zzatuchni/smart_watch/hw/screenshots/mc power supply.png

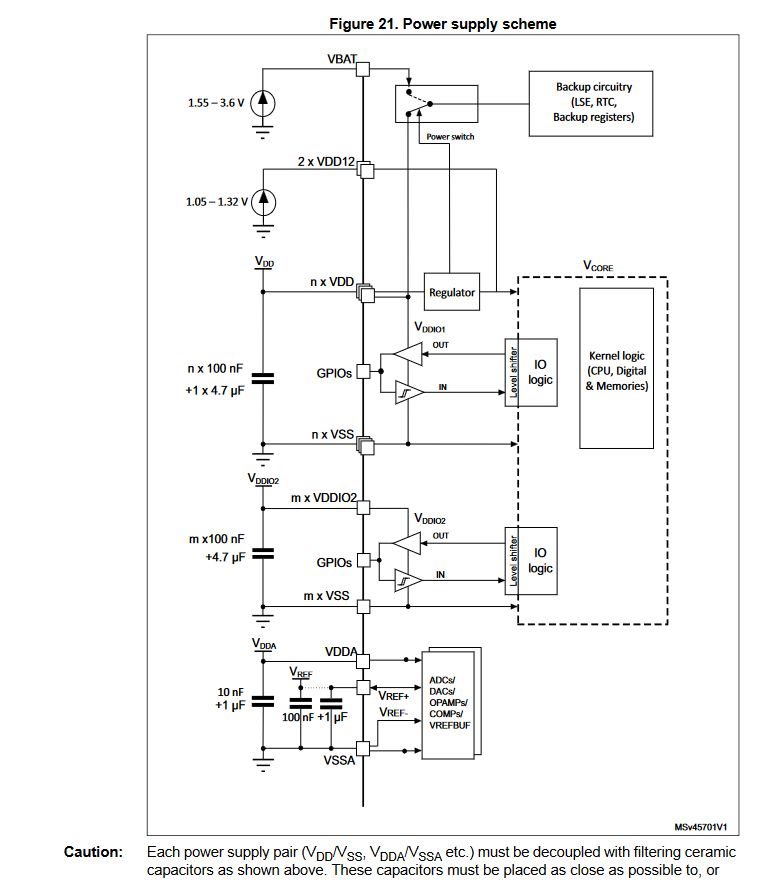
hw/screenshots/mc power supply.png
