zzatuchni/smart_watch/hw/kicad/smart_watch/smart_watch.kicad_pcb

## KiCad design hw/kicad/smart_watch/smart_watch.kicad_pcb (2025-05-13)

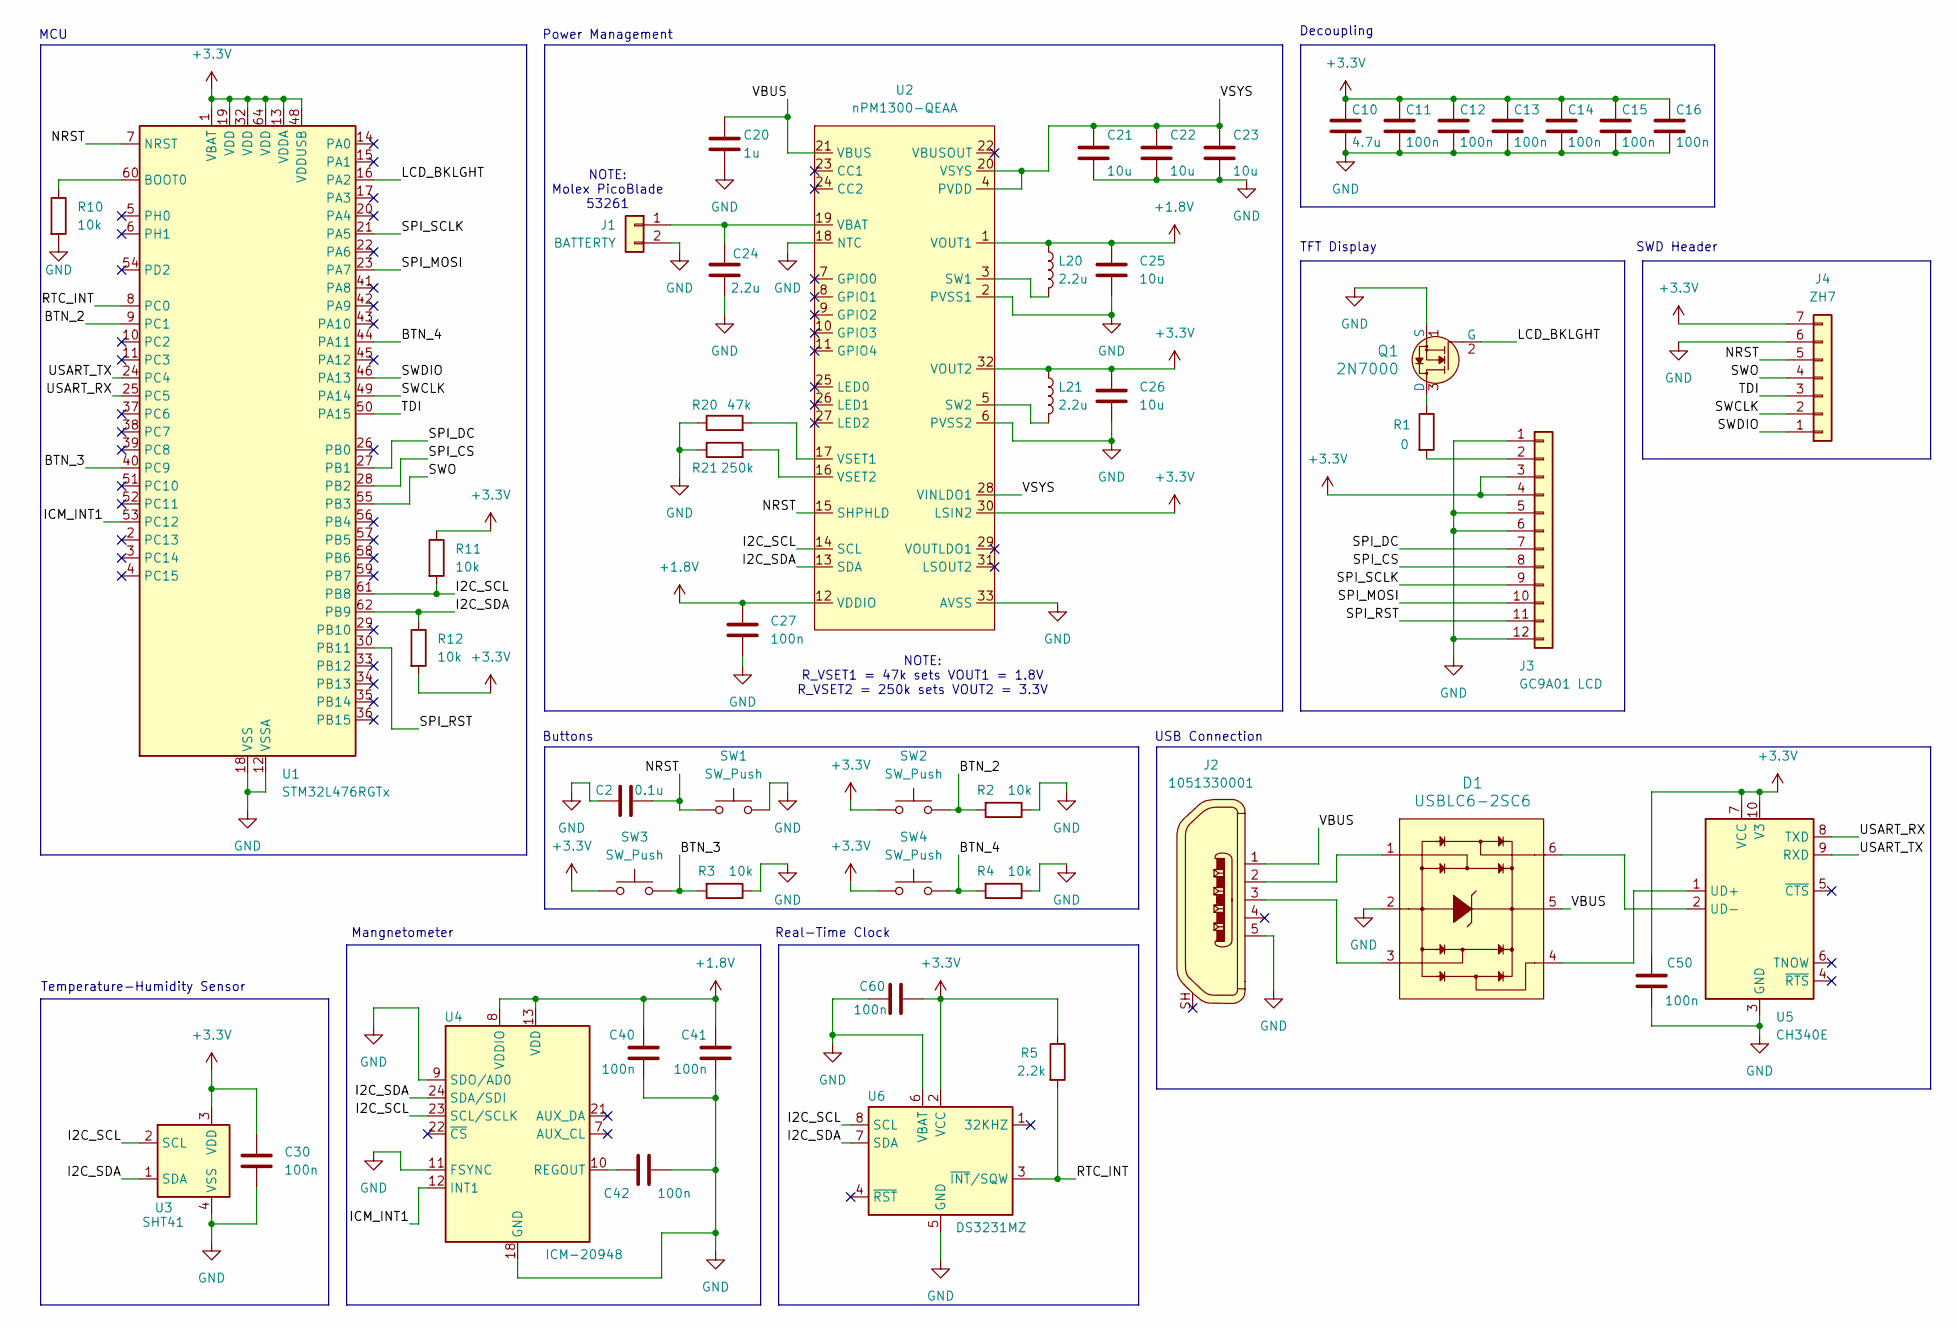
[picture p2: schematic smart_watch.kicad_sch, Smart Watch]

Parts:
C2: 0.1u; C_0603_1608Metric
C10: 4.7u; C_0603_1608Metric
C11, C12, C13, C14, C15, C16, C27, C30, C40, C41, C42, C50, C60: 100n; C_0603_1608Metric
C20: 1u; C_0603_1608Metric
C21, C22, C23, C25, C26: 10u; C_0603_1608Metric
C24: 2.2u; C_0603_1608Metric
D1: USBLC6-2SC6; SOT23-6L; MPN USBLC6-2SC6; Digi-Key_PN 497-5235-1-ND
J1: BATTERTY; Molex_PicoBlade_53261-0271_1x02-1MP_P1.25mm_Horizontal
J2: 1051330001; USB_Micro_B_Female_Vert_1051330001; MPN 1051330001; Digi-Key_PN WM9734CT-ND
J3: GC9A01 LCD; GC9A01_FPC_pads_P0.7mm
J4: ZH7; JST_ZH_S7B-ZR-SM4A-TF_1x07-1MP_P1.50mm_Horizontal
L20, L21: 2.2u; L_0603_1608Metric
Q1: 2N7000; SOT-23; MPN 2N7000; Digi-Key_PN 2N7000FS-ND
R1: 0; R_0603_1608Metric
R2, R3, R4, R10, R11, R12: 10k; R_0603_1608Metric
R5: 2.2k; R_0603_1608Metric
R20: 47k; R_0603_1608Metric
R21: 250k; R_0603_1608Metric
SW1, SW2, SW3, SW4: SW_Push; TL6340
U1: STM32L476RGTx; LQFP-64_10x10mm_P0.5mm
U2: nPM1300-QEAA; nPM1300
U3: SHT41; Sensirion_DFN-4_1.5x1.5mm_P0.8mm_SHT4x_NoCentralPad
U4: ICM-20948; InvenSense_QFN-24_3x3mm_P0.4mm
U5: CH340E; MSOP-10_3x3mm_P0.5mm
U6: DS3231MZ; SOIC-8_3.9x4.9mm_P1.27mm

Connections:
+1.8V: C25.1, C27.1, C40.2, C41.2, L20.1, U2.1 (VOUT1), U2.12 (VDDIO), U4.8 (VDDIO), U4.13 (VDD)
/BTN_2: R2.2, SW2.2, U1.9 (PC1)
/BTN_3: R3.2, SW3.2, U1.40 (PC9)
/BTN_4: R4.2, SW4.2, U1.44 (PA11)
/I2C_SCL: R11.2, U1.61 (PB8), U2.14 (SCL), U3.2 (SCL), U4.23 (SCL/SCLK), U6.8 (SCL)
/I2C_SDA: R12.1, U1.62 (PB9), U2.13 (SDA), U3.1 (SDA), U4.24 (SDA/SDI), U6.7 (SDA)
/ICM_INT1: U1.53 (PC12), U4.12 (INT1)
/LCD_BKLGHT: Q1.2 (G), U1.16 (PA2)
/NRST: C2.2, J4.5, SW1.1, U1.7 (NRST), U2.15 (SHPHLD)
/RTC_INT: R5.2, U1.8 (PC0), U6.3 (~INT/SQW)
/SPI_CS: J3.8, U1.28 (PB2)
/SPI_DC: J3.7, U1.27 (PB1)
/SPI_MOSI: J3.10, U1.23 (PA7)
/SPI_RST: J3.11, U1.30 (PB11)
/SPI_SCLK: J3.9, U1.21 (PA5)
/SWCLK: J4.2, U1.49 (PA14)
/SWDIO: J4.1, U1.46 (PA13)
/SWO: J4.4, U1.55 (PB3)
/TDI: J4.3, U1.50 (PA15)
/USART_RX: U1.25 (PC5), U5.8 (TXD)
/USART_TX: U1.24 (PC4), U5.9 (RXD)
/VBUS: C20.1, D1.5, J2.1, U2.21 (VBUS)
/VSYS: C21.2, C22.2, C23.2, U2.4 (PVDD), U2.20 (VSYS), U2.28 (VINLDO1)
unnamed: D1.1, J2.2
unnamed: D1.3, J2.3
unnamed: C24.1, J1.1, U2.19 (VBAT)
unnamed: J3.2, R1.2
unnamed: Q1.3 (D), R1.1
unnamed: R10.1, U1.60 (BOOT0)
unnamed: L20.2, U2.3 (SW1)
unnamed: L21.2, U2.5 (SW2)
unnamed: R20.2, U2.17 (VSET1)
unnamed: R21.2, U2.16 (VSET2)
unnamed: C42.2, U4.10 (REGOUT)
unnamed: D1.4, U5.1 (UD+)
unnamed: D1.6, U5.2 (UD-)

Notes on the sheet:
Mangnetometer
SWD Header
NOTE: Molex PicoBlade 53261
Temperature-Humidity Sensor
USB Connection
TFT Display
Power Management
Real-Time Clock
Buttons
NOTE: R_VSET1 = 47k sets VOUT1 = 1.8V R_VSET2 = 250k sets VOUT2 = 3.3V
MCU
Decoupling

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
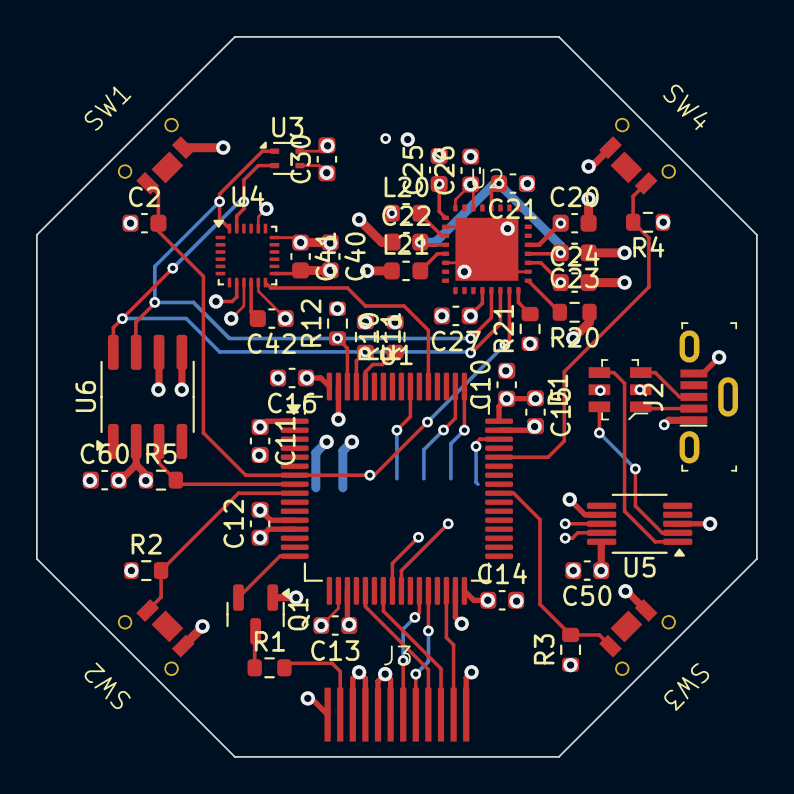
[picture p3: board smart_watch.kicad_pcb from above]

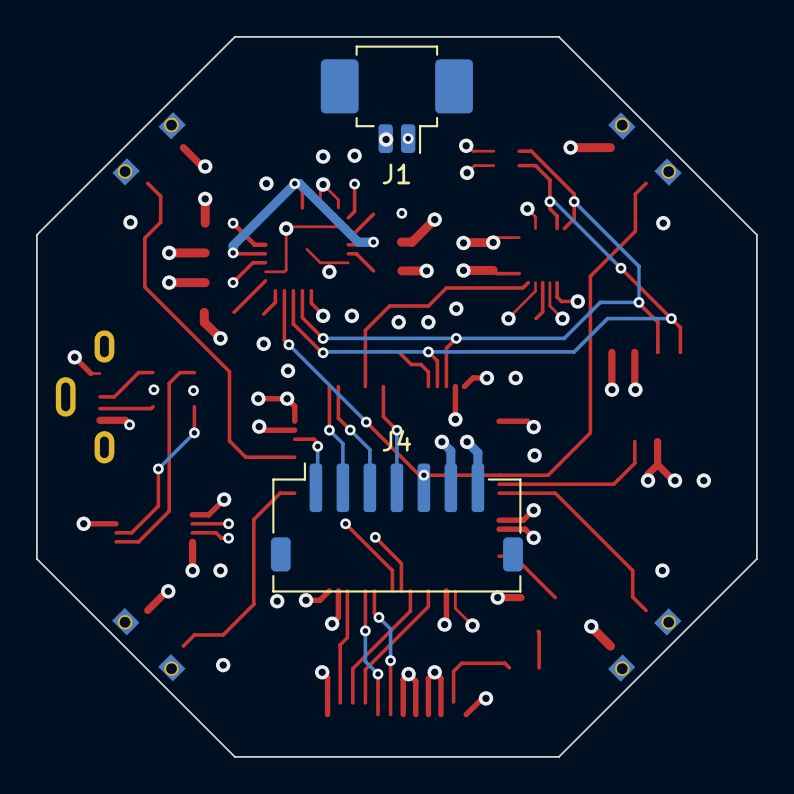
[picture p4: board smart_watch.kicad_pcb from below]

Board: 4 copper layers, 40.0 x 40.0 mm, 50 parts (2 on the bottom side), 38 nets.
