zzatuchni/smart_watch/sw/src/main.c

#include "devices/stm32l47x/basic.h"
#include "devices/stm32l47x/gpio.h"
#include "devices/stm32l47x/uart.h"
#include "devices/stm32l47x/rtc.h"

#include "devices/gc9a01/gc9a01.h"

#include "devices/sht41/sht41.h"

#include "devices/icm20948/icm20948.h"

#include "devices/lis2mdl/lis2mdl.h"

#include "devices/misc/misc.h"

#include "images/test_font.h"

#include "interrupts.h"
#include "debug.h"

////////////////////////////////////////////////////////////
//  Startup code 
////////////////////////////////////////////////////////////

char date_buf[12] = { '0' };
char date_buf_prev[12] = { '0' };

char temp_buf[2] = { '0' };
char temp_buf_prev[2] = { '0' };

const RTC_Time test_time = {
    2024,
    5,
    5,
    5,
    30,
    30,
    30
};

void dbg_print_date(RTC_Time *time) {
    DPRINT("WD ");
    DPRINTN(time->weekday);

    DPRINT(" Y ");
    DPRINTN(time->year);

    DPRINT(" M ");
    DPRINTN(time->month);

    DPRINT(" D ");
    DPRINTN(time->day);

    DPRINT(" h ");
    DPRINTN(time->hour);

    DPRINT(" m ");
    DPRINTN(time->minute);

    DPRINT(" s ");
    DPRINTN(time->second);

    DPRINT(" ss ");
    DPRINTN(time->subsecond);

    DPRINTNL();
}

int main(void) {
    ENABLE_DBG_TRACES();

    systick_init(DEFAULT_SYSCLK_FREQ / 1000);

    button_init(BUTTON1_PIN);

    Result res = gc9a01_init();
    if (res) { DPRINT("LCD INIT ERR "); DPRINTN(res); for (;;) {} };
    
    res = rtc_init();
    if (res) { DPRINT("RTC INIT ERR "); DPRINTN(res); for (;;) {} };

    res = i2c_init(&common_i2c_config);
    if (res) { DPRINT("I2C INIT ERR "); DPRINTN(res); for (;;) {} };

    //res = lis2mdl_init(&common_i2c_config);
    //if (res) { DPRINT("LIS2 INIT ERR "); DPRINTN(res); for (;;) {} };

    RTC_Time time;
    Temp_Humidity_Data th_data;
    //Magnetometer_Raw_Data mgmtr_data;

    // draw the backround
    const GC9A01_Frame bg_frame = {0, 0, GC9A01A_TFTWIDTH, GC9A01A_TFTHEIGHT};
    res = gc9a01_draw_colors_from_bitmask(checkerboard, 29, GC9A01A_BLUE2, GC9A01A_BLUE3, &bg_frame, 16);

    const int sx_scale2 = 16;
    const int sy_scale2 = 32;

    const int sx_scale3 = 24;
    const int sy_scale3 = 48;

    const int sx_scale5 = 40;
    const int sy_scale5 = 80;

    for (;;) {
        
        // gather data
        res = rtc_get_time(&time);
        if (res) { DPRINT("RTC GET TIME ERR "); DPRINTN(res); for (;;) {} };
        dbg_print_date(&time);

        int_to_str(time.hour, date_buf, 2, 10);
        int_to_str(time.minute, date_buf + 2, 2, 10);
        int_to_str(time.second, date_buf + 4, 2, 10);

        res = sht41_get_temp_hum_data(&th_data, SHT41_HI_PREC);
        if (res) { DPRINT("GET TEMP ERR "); DPRINTN(res); for (;;) {} };
        int_to_str(th_data.t_degC, temp_buf, 2, 10);

        DPRINT("TEMP ");
        DPRINTN(th_data.t_degC);
        DPRINT("\r\n");

        // start drawing
        GC9A01_Color col = GC9A01A_WHITE;

        int sx = sx_scale2;
        int sy = sy_scale2;
        GC9A01_Frame frame = { 182, 32, sx, sy };

        // write temp
        if (!str_cmp(temp_buf, temp_buf_prev, 2)) {
            gc9a01_draw_colors_from_bitmask(test_font_char_bitmap_bufs[temp_buf[0]-48], 16, col, GC9A01A_BLACK, &frame, 2);
            frame.x -= (sx + 2);
            gc9a01_draw_colors_from_bitmask(test_font_char_bitmap_bufs[temp_buf[1]-48], 16, col, GC9A01A_BLACK, &frame, 2);
            frame.x -= (sx + 2);
            gc9a01_draw_colors_from_bitmask(test_font_char_bitmap_bufs[15], 16, col, GC9A01A_BLACK, &frame, 2);
        }

        // write heading
        frame.x = 42;
        gc9a01_draw_colors_from_bitmask(test_font_char_bitmap_bufs[11], 16, col, GC9A01A_BLACK, &frame, 2);
        frame.x += (sx + 2);
        gc9a01_draw_colors_from_bitmask(test_font_char_bitmap_bufs[0], 16, col, GC9A01A_BLACK, &frame, 2);
        frame.x += (sx + 2);
        gc9a01_draw_colors_from_bitmask(test_font_char_bitmap_bufs[0], 16, col, GC9A01A_BLACK, &frame, 2);
        frame.x += (sx + 2);
        gc9a01_draw_colors_from_bitmask(test_font_char_bitmap_bufs[0], 16, col, GC9A01A_BLACK, &frame, 2);

        // write time
        sx = sx_scale5;
        sy = sy_scale5;
        GC9A01_Frame frame2 = { 10, 80, sx, sy };

        if (!str_cmp(date_buf+2, date_buf_prev+2, 2)) {
            gc9a01_draw_colors_from_bitmask(test_font_char_bitmap_bufs[date_buf[3]-48], 16, col, GC9A01A_BLACK, &frame2, 5);
            frame2.x += (sx + 5);
            gc9a01_draw_colors_from_bitmask(test_font_char_bitmap_bufs[date_buf[2]-48], 16, col, GC9A01A_BLACK, &frame2, 5);
        }
        
        frame2.x = 100;
        gc9a01_draw_colors_from_bitmask(test_font_char_bitmap_bufs[14], 16, col, GC9A01A_BLACK, &frame2, 5);
        frame2.x += (sx + 5);

        if (!str_cmp(date_buf, date_buf_prev, 2)) {
            gc9a01_draw_colors_from_bitmask(test_font_char_bitmap_bufs[date_buf[1]-48], 16, col, GC9A01A_BLACK, &frame2, 5);
            frame2.x += (sx + 5);
            gc9a01_draw_colors_from_bitmask(test_font_char_bitmap_bufs[date_buf[0]-48], 16, col, GC9A01A_BLACK, &frame2, 5);
        }
        


        // write date

        sx = sx_scale2;
        sy = sy_scale2;
        GC9A01_Frame frame3 = { 48, 180, sx, sy };
        gc9a01_draw_colors_from_bitmask(test_font_char_bitmap_bufs[0], 16, col, GC9A01A_BLACK, &frame3, 2);
        frame3.x += (sx + 2);
        gc9a01_draw_colors_from_bitmask(test_font_char_bitmap_bufs[0], 16, col, GC9A01A_BLACK, &frame3, 2);
        frame3.x += (sx + 2);
        gc9a01_draw_colors_from_bitmask(test_font_char_bitmap_bufs[16], 16, col, GC9A01A_BLACK, &frame3, 2);
        frame3.x += (sx + 2);
        gc9a01_draw_colors_from_bitmask(test_font_char_bitmap_bufs[0], 16, col, GC9A01A_BLACK, &frame3, 2);
        frame3.x += (sx + 2);
        gc9a01_draw_colors_from_bitmask(test_font_char_bitmap_bufs[0], 16, col, GC9A01A_BLACK, &frame3, 2);
        frame3.x += (sx + 2);
        gc9a01_draw_colors_from_bitmask(test_font_char_bitmap_bufs[16], 16, col, GC9A01A_BLACK, &frame3, 2);
        frame3.x += (sx + 2);
        gc9a01_draw_colors_from_bitmask(test_font_char_bitmap_bufs[0], 16, col, GC9A01A_BLACK, &frame3, 2);
        frame3.x += (sx + 2);
        gc9a01_draw_colors_from_bitmask(test_font_char_bitmap_bufs[0], 16, col, GC9A01A_BLACK, &frame3, 2);

        str_copy(date_buf, date_buf_prev, 6);
        str_copy(temp_buf, temp_buf_prev, 2);

        if (button1_pressed) {
            button1_pressed = false;
            DPRINT("Button pressed ");
            res = rtc_set_time(&test_time);
            if (res) { DPRINT("RTC SET TIME ERR "); DPRINTN(res); for (;;) {} };
        }

        spin(5000);
    }

    /*    
    for (;;) {
        res = rtc_get_time(&time);
        if (res) { DPRINT("RTC GET TIME ERR "); DPRINTN(res); for (;;) {} };

        int_to_str(time.hour, date_buf, 2, 10);
        int_to_str(time.minute, date_buf + 2, 2, 10);
        int_to_str(time.second, date_buf + 4, 2, 10);

        if (!str_cmp(date_buf, date_buf_prev, 2)) {
            gc9a01_draw_colors_from_bitmask(test_font_char_bitmap_bufs[date_buf[0]-48], 16, GC9A01A_WHITE, GC9A01A_BLACK, &ht_frame, 6);
            gc9a01_draw_colors_from_bitmask(test_font_char_bitmap_bufs[date_buf[1]-48], 16, GC9A01A_RED, GC9A01A_BLACK, &hu_frame, 6);
        }

        if (!str_cmp(date_buf+2, date_buf_prev+2, 2)) {
            gc9a01_draw_colors_from_bitmask(test_font_char_bitmap_bufs[date_buf[2]-48], 16, GC9A01A_WHITE, GC9A01A_BLACK, &mt_frame, 6);
            gc9a01_draw_colors_from_bitmask(test_font_char_bitmap_bufs[date_buf[3]-48], 16, GC9A01A_RED, GC9A01A_BLACK, &mu_frame, 6);
        }

        if (!str_cmp(date_buf+4, date_buf_prev+4, 2)) {
            gc9a01_draw_colors_from_bitmask(test_font_char_bitmap_bufs[date_buf[4]-48], 16, GC9A01A_WHITE, GC9A01A_BLACK, &st_frame, 4);
            gc9a01_draw_colors_from_bitmask(test_font_char_bitmap_bufs[date_buf[5]-48], 16, GC9A01A_RED, GC9A01A_BLACK, &su_frame, 4);   
        }

        str_copy(date_buf, date_buf_prev, 6);

        if (button1_pressed) {
            button1_pressed = false;
            DPRINT("Button pressed ");
            res = rtc_set_time(&test_time);
            if (res) { DPRINT("RTC SET TIME ERR "); DPRINTN(res); for (;;) {} };
        }

        res = sht41_get_temp_hum_data(&th_data, SHT41_HI_PREC);
        if (res) { DPRINT("GET TEMP ERR "); DPRINTN(res); for (;;) {} };

        //res = lis2mdl_get_raw_data(&mgmtr_data);
        //if (res) { DPRINT("GET MGMT ERR "); DPRINTN(res); for (;;) {} };

        DPRINT("TEMP ");
        DPRINTN(th_data.t_degC);
        DPRINT("\r\n");
        DPRINT("HUM ");
        DPRINTN(th_data.rh_pRH);
        DPRINT("\r\n");
        //DPRINT("X ");
        //DPRINTNS((int32_t)mgmtr_data.x);
        //DPRINT("\r\n");
        //DPRINT("Y ");
        //DPRINTNS((int32_t)mgmtr_data.y);
        //DPRINT("\r\n");
        //DPRINT("Z ");
        //DPRINTNS((int32_t)mgmtr_data.z);
        //DPRINT("\r\n");

        //int16_t deg = lis2mdl_get_heading_degrees(mgmtr_data.y, mgmtr_data.x);
        //DPRINT("DEG ");
        //DPRINTNS((int32_t)mgmtr_data.z);
        //DPRINT("\r\n");

        spin(500000);
    }
    */

    return 0;
}

__attribute__((naked, noreturn)) void _reset(void) {
  // memset .bss to zero, and copy .data section to RAM region
  extern long _sbss, _ebss, _sdata, _edata, _sidata;
  for (long *dst = &_sbss; dst < &_ebss; dst++) *dst = 0;
  for (long *dst = &_sdata, *src = &_sidata; dst < &_edata;) *dst++ = *src++;

  main();             // Call main()
  for (;;) (void) 0;  // Infinite loop in the case if main() returns
}

extern void _estack(void);  // Defined in link.ld

// 16 standard and 91 STM32-specific handlers
__attribute__((section(".vectors"))) void (*const volatile tab[16 + 99])(void) = {
    _estack, _reset, 0, _on_hard_fault, _on_mem_fault, _on_bus_fault, _on_usage_fault, 0, 0, 0, 0, 0, 0, 0, 0, _on_systick,  //ARM core interrupts
    0, 0, 0, 0, 0, 0, 0, 0, 0, 0, 0, 0, 0, 0, 0, 0, // 0 - 15
    0, 0, 0, 0, 0, 0, 0, 0, 0, 0, 0, 0, 0, 0, 0, 0, // 16 - 31
    0, 0, 0, 0, 0, 0, _on_uart2_interrupt, 0, _on_button1_press, 0, 0, 0, 0, 0, 0, 0, // 32 - 47
    0, 0, 0, 0, 0, 0, 0, 0, 0, 0, 0, 0, 0, 0, 0, 0, // 48 - 63
    0, 0, 0, 0, 0, 0, 0, 0, 0, 0, 0, 0, 0, 0, 0, 0, // 64 - 79
    0, 0, 0, 0, 0, 0, 0, 0, 0, 0, 0, 0, 0, 0, 0, 0, // 80 - 96
    };
