zzatuchni/smart_watch/(commit log)

2024-12-06 uart communication
2025-01-08 starting i2c
2025-01-09 more i2c
2025-01-11 Start schematic
    [smart_watch.kicad_sch]
2025-01-14 block diagram
    [smart_watch.kicad_sch]
2025-01-15 work on kicad schematic
    [smart_watch.kicad_sch]
2025-01-19 i2c works
2025-01-19 getting magnetic data
2025-02-02 schematic done?
    [smart_watch.kicad_sch]
2025-02-03 pmic footprint
    [smart_watch.kicad_sch]
2025-02-06 more part selection pt 1
    [smart_watch.kicad_pcb, smart_watch.kicad_sch]
2025-02-07 start pcb
    [smart_watch.csv, smart_watch.kicad_pcb, smart_watch.kicad_sch]
2025-02-09 added rtc chip to board
    [smart_watch.kicad_pcb, smart_watch.kicad_sch]
2025-02-11 pcb design part 1
    [smart_watch.kicad_pcb, smart_watch.kicad_sch]
2025-02-12 pcb design part 2
    [smart_watch.kicad_pcb, smart_watch.kicad_sch]
2025-02-21 layout attempt 2
    [smart_watch.kicad_pcb, smart_watch.kicad_sch, smart_watch_draft.kicad_pcb]
2025-02-23 layout attempt 2 part 2
    [smart_watch.kicad_pcb, smart_watch.kicad_sch]
2025-02-23 layout attempt 2 part 3
    [smart_watch.kicad_pcb]
2025-03-20 back at the pcb design
    [smart_watch.kicad_pcb]
2025-04-23 Starting this again
    [smart_watch_draft1.kicad_pcb, smart_watch_draft2.kicad_pcb]
2025-05-02 pcb design again pt 1
    [smart_watch.kicad_pcb, smart_watch.kicad_sch]
2025-05-04 pcb design again pt 2
    [smart_watch.kicad_pcb]
2025-05-08 pcb design again pt 3
    [smart_watch.kicad_pcb, smart_watch.kicad_sch]
2025-05-13 pcb design again pt 4
    [smart_watch.kicad_pcb]
